lhr-solar/BPS-VoltTemp/hardware/VoltTemp/VoltTempBOM.xlsx

Reference | Value | P/N | Footprint | Qty | DNP
D15 | BQ_HB | XL-1608UBC-06A | LED_SMD:LED_0603_1608Metric_Pad1.05x0.95mm_HandSolder | 1
D10 | 3v3 | XL-1608UBC-06A | LED_SMD:LED_0603_1608Metric_Pad1.05x0.95mm_HandSolder | 1
R34,R38,R43,R44,R50 | 27k | TNPU060327K0AYEN00 | Resistor_SMD:R_0603_1608Metric_Pad0.98x0.95mm_HandSolder | 5
U4,U6,U12,U13,U14 | TLV9062xD | TLV9062QDGKRQ1 | Package_SO:SOIC-8_3.9x4.9mm_P1.27mm | 5
SW1 | BOOT | TL3365AF180QG | VoltTemp:SW_TL3365AF180QG | 1
R25,R26,R28,R30 | 0 | SFR03EZPJ000 | Resistor_SMD:R_0603_1608Metric_Pad0.98x0.95mm_HandSolder | 4
R23,R24,R27 | 0 | SFR03EZPJ000 | Resistor_SMD:R_0603_1608Metric_Pad0.98x0.95mm_HandSolder | 3
R35,R36,R39,R40,R45,R46,R47,R48,R51,R52 | 2.7k | SFR03EZPF2701 | Resistor_SMD:R_0603_1608Metric_Pad0.98x0.95mm_HandSolder | 10
J5 | Logic_Analyzer | SFH11-PBPC-D05-ST-BK | UTSVT_Connectors:CONN_SFH11-xxxC-D05-ST-XX_SUL | 1
F7,F8,F9,F10,F11 | 10mA | PTSLR06038V075 | VoltTemp:ptc_fuse_FUSC1607X75N | 5
D14 | BQ-Fault | NCD0603R1 | LED_SMD:LED_0603_1608Metric_Pad1.05x0.95mm_HandSolder | 1
C3,C26,C28,C29,C32,C34,C35,C36,C37,C38,C39,C40,C41 | 1uF | MLASU168SB5105KTNA01 | Capacitor_SMD:C_0603_1608Metric_Pad1.08x0.95mm_HandSolder,Capacitor_SMD:C_0805_2012Metric_Pad1.18x1.45mm_HandSolder | 13
C10,C11,C12,C13,C14,C15,C16,C17 | 100nF | MLASH168SB7104KTNA01 | Capacitor_SMD:C_0603_1608Metric_Pad1.08x0.95mm_HandSolder | 8
C5,C6,C7,C8,C9,C24,C42 | 0.1uF | MLASH168SB7104KTNA01 | Capacitor_SMD:C_0603_1608Metric_Pad1.08x0.95mm_HandSolder | 7
IC1 | ISO1641BDR | ISO1641BDR | VoltTemp:ISO1641BDR | 1
C2 | 10uF | GRM21BR61H106KE43K | Capacitor_SMD:C_0805_2012Metric | 1
F12 | 40mA | FUSC1607X75N | VoltTemp:ptc_fuse_FUSC1607X75N | 1
R53,R54,R55,R56,R57,R58,R59,R60 | 100Œ© | ESR03EZPF1000 | Resistor_SMD:R_0603_1608Metric_Pad0.98x0.95mm_HandSolder | 8
R1,R37,R41,R42,R49 | 8.2kŒ© | ERA-3AED822V | Resistor_SMD:R_0603_1608Metric_Pad0.98x0.95mm_HandSolder | 5
U1,U3 | EL3H7 | EL3H7(D)(TA)-VG | UTSVT_ICs:EL3H7 | 2
R31 | 4.3k | CRCW06034K30FKTA | Resistor_SMD:R_0603_1608Metric_Pad0.98x0.95mm_HandSolder | 1
R5 | 2k | CRCW06032K10FKEA | Resistor_SMD:R_0805_2012Metric | 1
R8,R12 | 1k | CRCW06031K00FKEI | Resistor_SMD:R_0603_1608Metric_Pad0.98x0.95mm_HandSolder | 2
R9,R10,R11,R13,R14,R15 | 10k | CRCW060310K0FKEI | Resistor_SMD:R_0603_1608Metric_Pad0.98x0.95mm_HandSolder | 6
R18,R19 | 120 | CRCW0603120RFKEC | Resistor_SMD:R_0603_1608Metric_Pad0.98x0.95mm_HandSolder | 2
R2 | 510k | CPF0603B510KE1 | Resistor_SMD:R_0603_1608Metric_Pad0.98x0.95mm_HandSolder | 1
C25,C27,C30,C31,C33 | 1.2uF | C0805C125K4RACTU | Capacitor_SMD:C_0805_2012Metric_Pad1.18x1.45mm_HandSolder | 5
U2 | BQ7692003PW | BQ7692003PW | VoltTemp:BQ7692003PW | 1
J10 | 53307-2471 | 53307-2471 | UTSVT_Connectors:PeripheralSOM | 1
D1 | D_Zener_Small | 1N448W | Diode_SMD:D_0805_2012Metric | 1
C18 | 4.7uF | 08055D475KAT4A | Capacitor_SMD:C_0805_2012Metric_Pad1.18x1.45mm_HandSolder | 1
C4 | 470pF | 06035C471J4Z2A | Capacitor_SMD:C_0603_1608Metric_Pad1.08x0.95mm_HandSolder | 1
J6,J7,J12,J13 | Conn_01x04 | 1053132104 | VoltTemp:1053132104 | 4
J11 | Conn_01x07 | 1053131107 | VoltTemp:1053131107 | 1
J8 | Conn_01x06 | 1053131106 | VoltTemp:1053131106 | 1
J9 | Conn_01x03 | 1053131103 | VoltTemp:1053131103 | 1
D2,D3,D4,D5,D6,D7,D8,D9 | WS2812B-2020 |  | LED_SMD:LED_WS2812B-2020_PLCC4_2.0x2.0mm | 8
