lhr-solar/BPS-VoltTemp/hardware/Scrutineering/BOM/Scrutineering.xlsx

Reference | Value | P/N | Footprint | Qty
J5,J6,J7,J8,J9,J10 | Conn_01x01 | 105-2210-201 | UTSVT_Connectors:Banana_Jack_1_Pin_4mm | 6
J11,J11 | Conn_01x02 | 1053132102 | UTSVT_Connectors:105313-2102 | 2
J3,J4 | Conn_01x03 | 1053131103 | VoltTemp:1053131103 | 2
J1,J2 | Conn_02x04 | 1053141108 | Scrutineering:nanofit_02x04 | 2
SW1,SW2,SW3,SW4 | SW_SPDT | OS102011MS2Q | Button_Switch_THT:SW_Slide_SPDT_Straight_CK_OS102011MS2Q | 4
