lhr-solar/BPS-VoltTemp/hardware/TestBoard_CellSimulator/BOM/CellSimulatorPCB_BOM.xlsx

Reference | Qty | Value | Footprint | Datasheet | P/N
J1,J2 | 2 | 575-4 | VoltTemp:5754 | https://www.digikey.com/en/products/detail/keystone-electronics/575-4/318493 | 575-4
J11 | 1 | Conn_01x07 | VoltTemp:1053131107 | ~ | 1053131107
R1,R2,R3,R4,R5 | 5 | 7.23 kŒ© | Resistor_SMD:R_0603_1608Metric_Pad0.98x0.95mm_HandSolder | https://www.mouser.com/ProductDetail/Vishay/TNPW06037K23BEEN?qs=m2vMjz15CltNt%2FYw8X6%252BTg%3D%3D | TNPW06037K23BEEN
TP9,TP10,TP11,TP12,TP13,TP14 | 6 | TestPoint | TestPoint:TestPoint_Keystone_5005-5009_Compact | ~ | 5005
