lhr-solar/BPS-VoltTemp/hardware/TestBoard_ThermistorBreakout/BOM/ThermistorBreakoutPCB_BOM.xlsx

Reference | Qty | Value | Footprint | Datasheet | P/N
J8 | 1 | Conn_01x06 | VoltTemp:1053131106 | ~ | 1053131106
R5,R6,R7,R8,R9,R10,R11,R12 | 8 | 6.49k | Resistor_SMD:R_0603_1608Metric_Pad0.98x0.95mm_HandSolder | https://www.mouser.com/ProductDetail/YAGEO/RT0603DRE076K49L?qs=4CyHz7GXqSi0aK3%2FrppBIQ%3D%3D | RT0603DRE076K49L
TH5,TH6,TH7,TH8 | 4 | Thermistor_NTC | UTSVT_Special:THERM_ERT-J1VR104FM | https://industrial.panasonic.com/cdbs/www-data/pdf/AUA0000/AUA0000C11.pdf | ERTJ1VR104FM
