lhr-solar/BPS-VoltTemp/hardware/spice/TemperatureFilter.asc

C1: cap; 1µ
C2: cap; 1.2µ
R1: res; 226.2k
R2: res; 6.49k
R3: res; 8.2k
R4: res; 27k
R5: res; 2.7k
R6: res; 2.7k
U1: opamp
U2: opamp
V1: voltage; 3.3
V2: voltage; 1; AC 1 1
Named nets: 3.3V-AC, 0, Vout, 3.3V, Buf, Filter
226.2k Ohm at 10C
6,834 Ohm at 85C
.op
.lib opamp.sub
