lhr-solar/BPS-VoltTemp/hardware/Scrutineering/Scrutineering.kicad_pcb

## KiCad design hardware/Scrutineering/Scrutineering.kicad_pcb (2025-09-22)

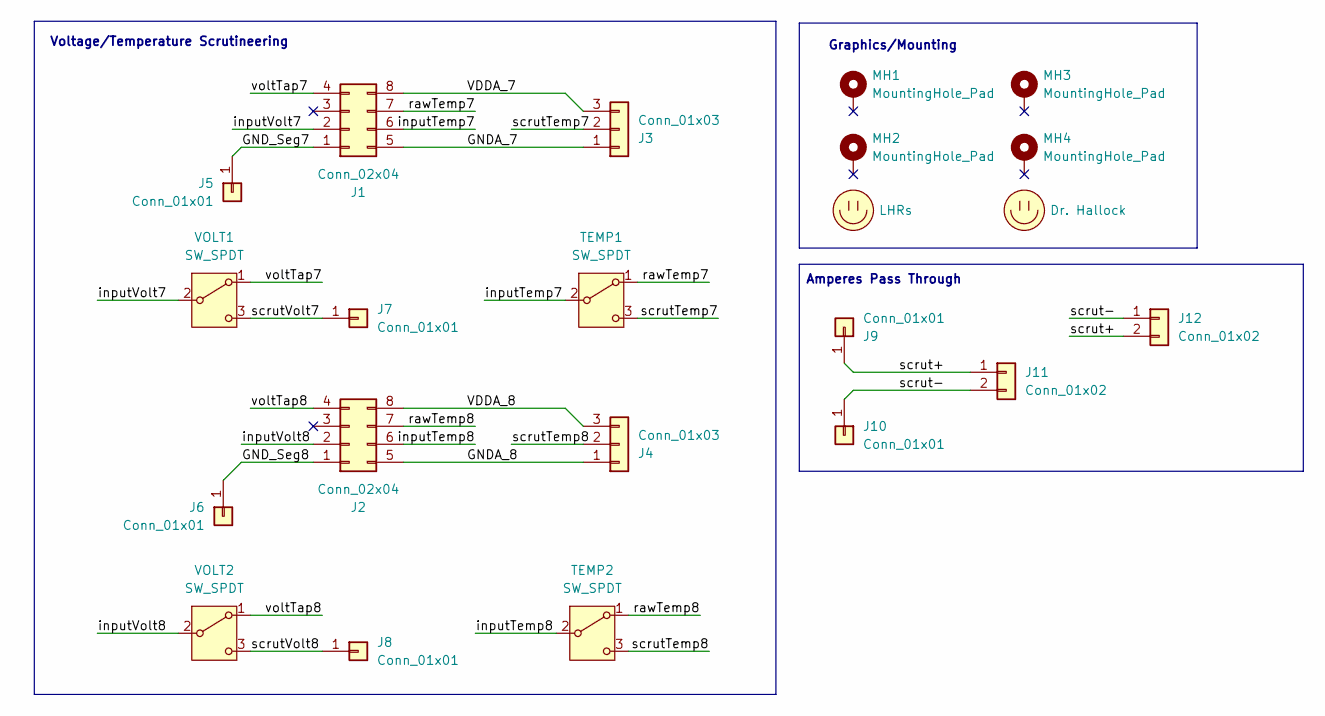
[picture p1: schematic Scrutineering.kicad_sch]

Parts:
J1, J2: Conn_02x04; nanofit_02x04
J3, J4: Conn_01x03; 1053131103
J5, J6, J7, J8, J9, J10: Conn_01x01; Banana_Jack_1_Pin_4mm
J11, J12: Conn_01x02; 105313-2102
LOGO1: Dr. Hallock; Hallock_Image_Small
LOGO2: LHRs; LHRs_LOGO
MH1, MH2, MH3, MH4: MountingHole_Pad; MountingHole_3.2mm_M3_Pad_TopBottom
TEMP1, TEMP2: SW_SPDT; SW_Slide_SPDT_Straight_CK_OS102011MS2Q
VOLT1, VOLT2: SW_SPDT; SW_Slide_SPDT_Straight_CK_OS102011MS2Q

Connections:
/GNDA_7: J1.5, J3.1
/GNDA_8: J2.5, J4.1
/GND_Seg7: J1.1, J5.1
/GND_Seg8: J2.1, J6.1
/VDDA_7: J1.8, J3.3
/VDDA_8: J2.8, J4.3
/inputTemp7: J1.6, TEMP1.2 (B)
/inputTemp8: J2.6, TEMP2.2 (B)
/inputVolt7: J1.2, VOLT1.2 (B)
/inputVolt8: J2.2, VOLT2.2 (B)
/rawTemp7: J1.7, TEMP1.1 (A)
/rawTemp8: J2.7, TEMP2.1 (A)
/scrut+: J9.1, J11.1, J12.2
/scrut-: J10.1, J11.2, J12.1
/scrutTemp7: J3.2, TEMP1.3 (C)
/scrutTemp8: J4.2, TEMP2.3 (C)
/scrutVolt7: J7.1, VOLT1.3 (C)
/scrutVolt8: J8.1, VOLT2.3 (C)
/voltTap7: J1.4, VOLT1.1 (A)
/voltTap8: J2.4, VOLT2.1 (A)

Notes on the sheet:
Amperes Pass Through
Voltage/Temperature Scrutineering
Graphics/Mounting

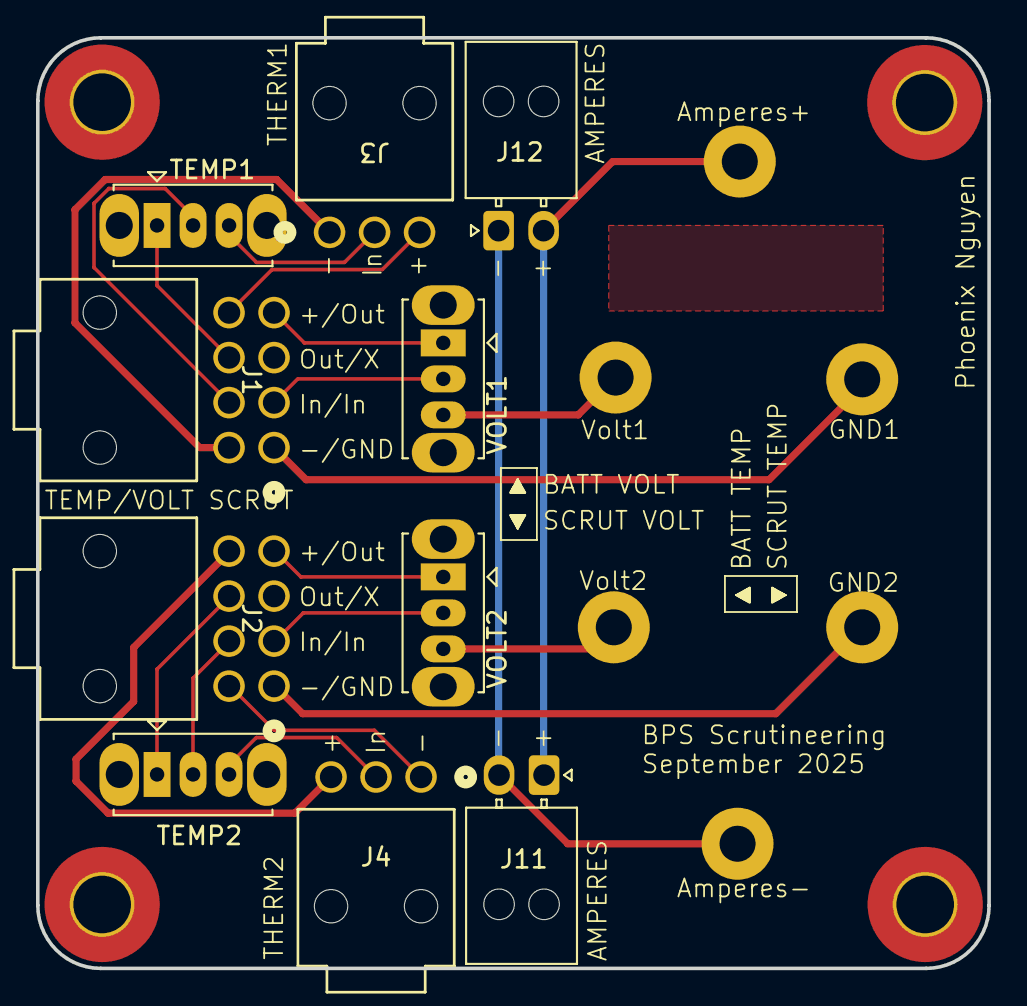
[picture p2: board Scrutineering.kicad_pcb from above]

Board: 2 copper layers, 52.8 x 51.7 mm, 22 parts (1 on the bottom side), 20 nets.
