lhr-solar/BPS-VoltTemp/hardware/TestBoard_CellSimulator/CellSimulatorPCB.kicad_pcb

## KiCad design hardware/TestBoard_CellSimulator/CellSimulatorPCB.kicad_pcb (2025-08-24)

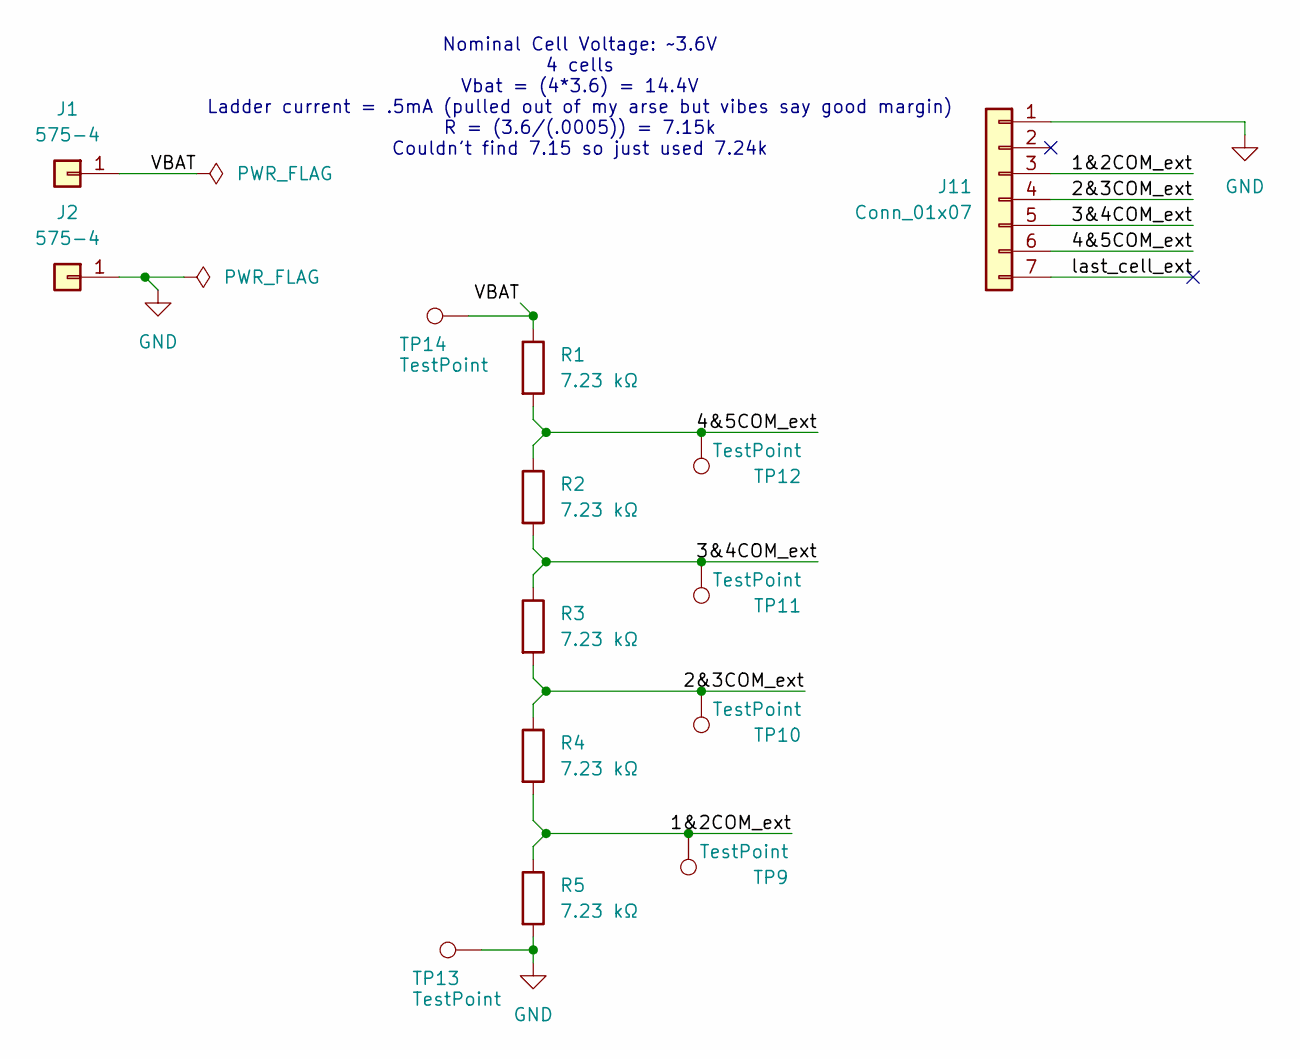
[picture p3: schematic CellSimulatorPCB.kicad_sch]

Parts:
J1, J2: 575-4; 5754
J11: Conn_01x07; 1053131107
R1, R2, R3, R4, R5: 7.23 kΩ; R_0603_1608Metric_Pad0.98x0.95mm_HandSolder
TP9, TP10, TP11, TP12, TP13, TP14: TestPoint; TestPoint_Keystone_5005-5009_Compact

Connections:
/1&2COM_ext: J11.3, R4.2, R5.1, TP9.1
/2&3COM_ext: J11.4, R3.2, R4.1, TP10.1
/3&4COM_ext: J11.5, R2.2, R3.1, TP11.1
/4&5COM_ext: J11.6, R1.2, R2.1, TP12.1
/VBAT: J1.1, R1.1, TP14.1
/last_cell_ext: J11.7
GND: J2.1, J11.1, R5.2, TP13.1

Notes on the sheet:
Nominal Cell Voltage: ~3.6V 4 cells Vbat = (4*3.6) = 14.4V Ladder current = .5mA (pulled out of my arse but vibes say good margin) R = (3.6/(.0005)) = 7.15k Couldn't find 7.15 so just used 7.24k

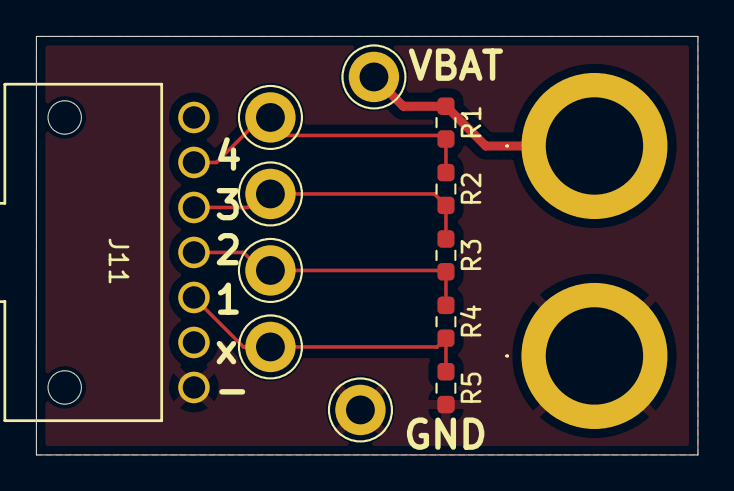
[picture p4: board CellSimulatorPCB.kicad_pcb from above]

Board: 2 copper layers, 36.8 x 23.2 mm, 14 parts (0 on the bottom side), 6 nets.
