lhr-solar/BPS-VoltTemp/hardware/TestBoard_ThermistorBreakout/ThermistorBreakoutPCB.kicad_pcb

## KiCad design hardware/TestBoard_ThermistorBreakout/ThermistorBreakoutPCB.kicad_pcb (2025-08-22)

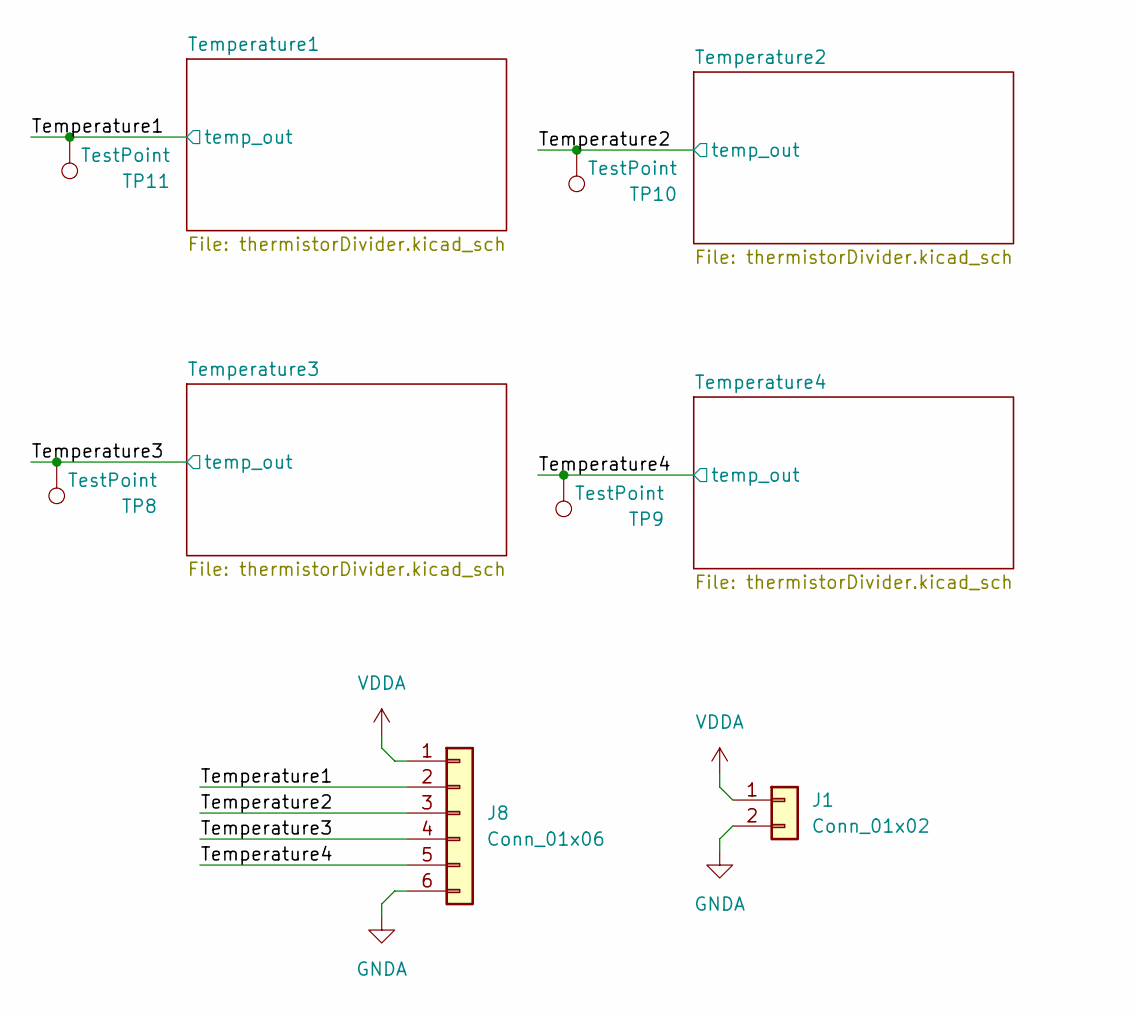
[picture p5: schematic ThermistorBreakoutPCB.kicad_sch]

Parts:
J1: Conn_01x02; PinHeader_1x02_P2.54mm_Vertical
J8: Conn_01x06; 1053131106
TP8, TP9, TP10, TP11: TestPoint; TestPoint_Keystone_5005-5009_Compact

Connections:
/Temperature1: J8.2, TP11.1; also elsewhere on the board
/Temperature2: J8.3, TP10.1; also elsewhere on the board
/Temperature3: J8.4, TP8.1; also elsewhere on the board
/Temperature4: J8.5, TP9.1; also elsewhere on the board
GNDA: J1.2, J8.6; also elsewhere on the board
VDDA: J1.1, J8.1; also elsewhere on the board

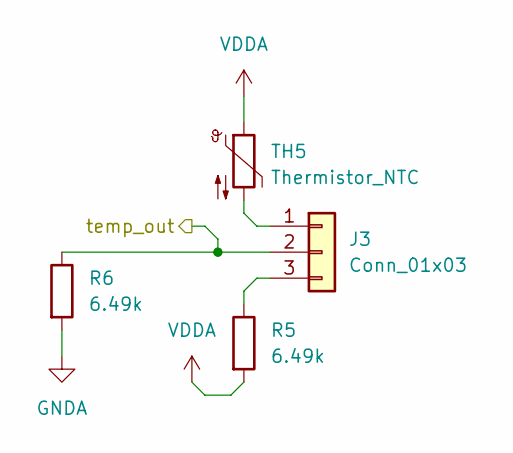
[picture p6: schematic thermistorDivider.kicad_sch]

Parts:
J3: Conn_01x03; PinHeader_1x03_P2.54mm_Vertical
R5, R6: 6.49k; R_0603_1608Metric_Pad0.98x0.95mm_HandSolder
TH5: Thermistor_NTC; THERM_ERT-J1VR104FM

Connections:
/Temperature1: J3.2, R6.1; also elsewhere on the board
GNDA: R6.2; also elsewhere on the board
unnamed: J3.1, TH5.2
unnamed: J3.3, R5.1
VDDA: R5.2, TH5.1; also elsewhere on the board

Parts of its further copies:
J4, J5, J6: Conn_01x03; PinHeader_1x03_P2.54mm_Vertical
R7, R8, R9, R10, R11, R12: 6.49k; R_0603_1608Metric_Pad0.98x0.95mm_HandSolder
TH6, TH7, TH8: Thermistor_NTC; THERM_ERT-J1VR104FM

Connections of its further copies:
/Temperature2: J4.2, R7.1; also elsewhere on the board
/Temperature3: J5.2, R9.1; also elsewhere on the board
/Temperature4: J6.2, R10.1; also elsewhere on the board
GNDA: R7.2, R9.2, R10.2; also elsewhere on the board
unnamed: J4.1, TH6.2
unnamed: J4.3, R8.1
unnamed: J5.1, TH7.2
unnamed: J5.3, R11.1
unnamed: J6.1, TH8.2
unnamed: J6.3, R12.1
VDDA: R8.2, R11.2, R12.2, TH6.1, TH7.1, TH8.1; also elsewhere on the board

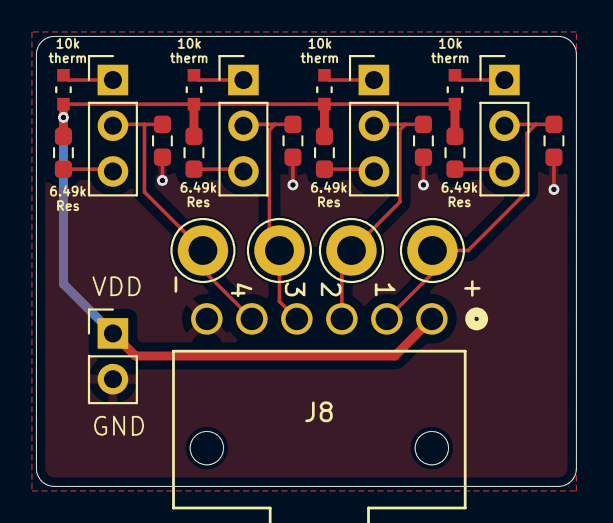
[picture p7: board ThermistorBreakoutPCB.kicad_pcb from above]

Board: 2 copper layers, 30.0 x 25.0 mm, 22 parts (0 on the bottom side), 14 nets.
