lhr-solar/BPS-VoltTemp/hardware/VoltTemp/BPS-Voltage_Temp_Board.kicad_pcb

## KiCad design hardware/VoltTemp/BPS-Voltage_Temp_Board.kicad_pcb (2025-08-26)

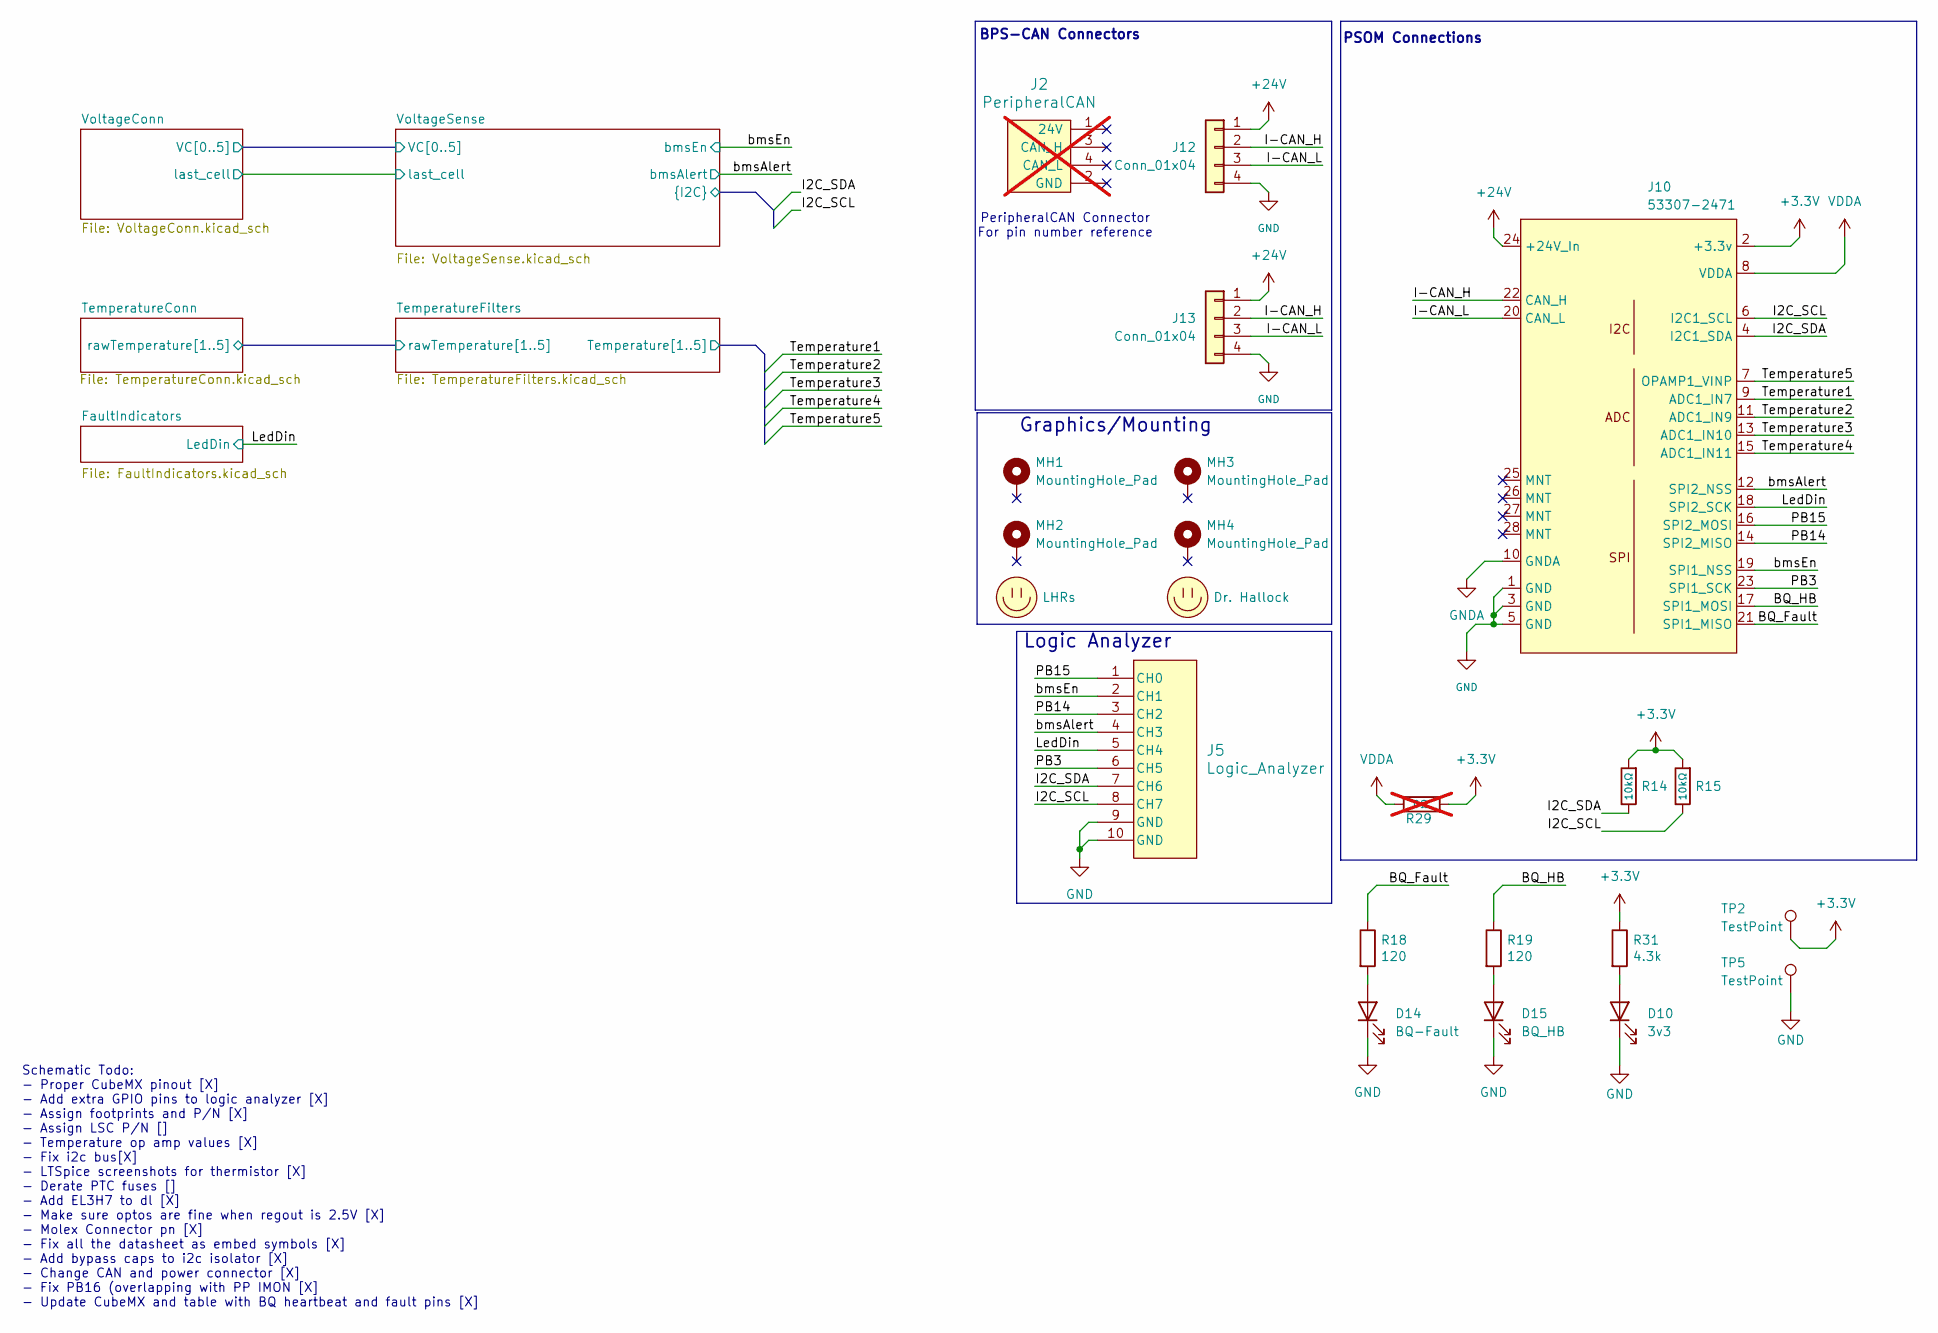
[picture p8: schematic BPS-Voltage_Temp_Board.kicad_sch, BPS Voltage&Temperature board]

Parts:
D10: 3v3; LED_0603_1608Metric_Pad1.05x0.95mm_HandSolder
D14: BQ-Fault; LED_0603_1608Metric_Pad1.05x0.95mm_HandSolder
D15: BQ_HB; LED_0603_1608Metric_Pad1.05x0.95mm_HandSolder
J2: PeripheralCAN; Molex_Nano-Fit_105309-xx04_1x04_P2.50mm_Vertical; not fitted
J5: Logic_Analyzer; CONN_SFH11-xxxC-D05-ST-XX_SUL
J10: 53307-2471; PeripheralSOM
J12, J13: Conn_01x04; 1053132104
LOGO1: Dr. Hallock; Hallock_Image_Small
LOGO2: LHRs; LHRs_LOGO
MH1, MH2, MH3, MH4: MountingHole_Pad; MountingHole_3.2mm_M3_Pad_TopBottom
R14, R15: 10kΩ; R_0603_1608Metric_Pad0.98x0.95mm_HandSolder
R18, R19: 120; R_0603_1608Metric_Pad0.98x0.95mm_HandSolder
R29: 0Ω; R_0603_1608Metric_Pad0.98x0.95mm_HandSolder; not fitted
R31: 4.3k; R_0603_1608Metric_Pad0.98x0.95mm_HandSolder
TP2, TP5: TestPoint; TestPoint_Pad_1.0x1.0mm

Connections:
+3.3V: J10.2 (+3.3v), R14.2, R15.2, R29.2, R31.1, TP2.1; also elsewhere on the board
+24V: J10.24 (+24V_In), J12.1, J13.1
/BQ_Fault: J10.21 (SPI1_MISO), R18.1
/BQ_HB: J10.17 (SPI1_MOSI), R19.1
/I-CAN_H: J10.22 (CAN_H), J12.2, J13.2
/I-CAN_L: J10.20 (CAN_L), J12.3, J13.3
/LedDin: J5.5 (CH4), J10.18 (SPI2_SCK); also elsewhere on the board
/PB3: J5.6 (CH5), J10.23 (SPI1_SCK)
/PB14: J5.3 (CH2), J10.14 (SPI2_MISO)
/PB15: J5.1 (CH0), J10.16 (SPI2_MOSI)
/TemperatureFilters/Temperature1: J10.9 (ADC1_IN7); also elsewhere on the board
/TemperatureFilters/Temperature2: J10.11 (ADC1_IN9); also elsewhere on the board
/TemperatureFilters/Temperature3: J10.13 (ADC1_IN10); also elsewhere on the board
/TemperatureFilters/Temperature4: J10.15 (ADC1_IN11); also elsewhere on the board
/TemperatureFilters/Temperature5: J10.7 (OPAMP1_VINP); also elsewhere on the board
/VoltageSense/I2C_SCL: J5.8 (CH7), J10.6 (I2C1_SCL), R15.1; also elsewhere on the board
/VoltageSense/I2C_SDA: J5.7 (CH6), J10.4 (I2C1_SDA), R14.1; also elsewhere on the board
/bmsAlert: J5.4 (CH3), J10.12 (SPI2_NSS); also elsewhere on the board
/bmsEn: J5.2 (CH1), J10.19 (SPI1_NSS); also elsewhere on the board
GND: D10.1 (K), D14.1 (K), D15.1 (K), J5.9 (GND), J5.10 (GND), J10.1 (GND), J10.3 (GND), J10.5 (GND), J12.4, J13.4, TP5.1; also elsewhere on the board
GNDA: J10.10 (GNDA); also elsewhere on the board
unnamed: D10.2 (A), R31.2
unnamed: D14.2 (A), R18.2
unnamed: D15.2 (A), R19.2
VDDA: J10.8 (VDDA), R29.1; also elsewhere on the board

Notes on the sheet:
BPS-CAN Connectors
Logic Analyzer
Schematic Todo: - Proper CubeMX pinout [X] - Add extra GPIO pins to logic analyzer [X] - Assign footprints and P/N [X] - Assign LSC P/N [] - Temperature op amp values [X] - Fix i2c bus[X] - LTSpice screenshots for thermistor [X] - Derate PTC fuses [] - Add EL3H7 to dl [X] - Make sure optos are fine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
PSOM Connections
PeripheralCAN Connector For pin number reference
Graphics/Mounting

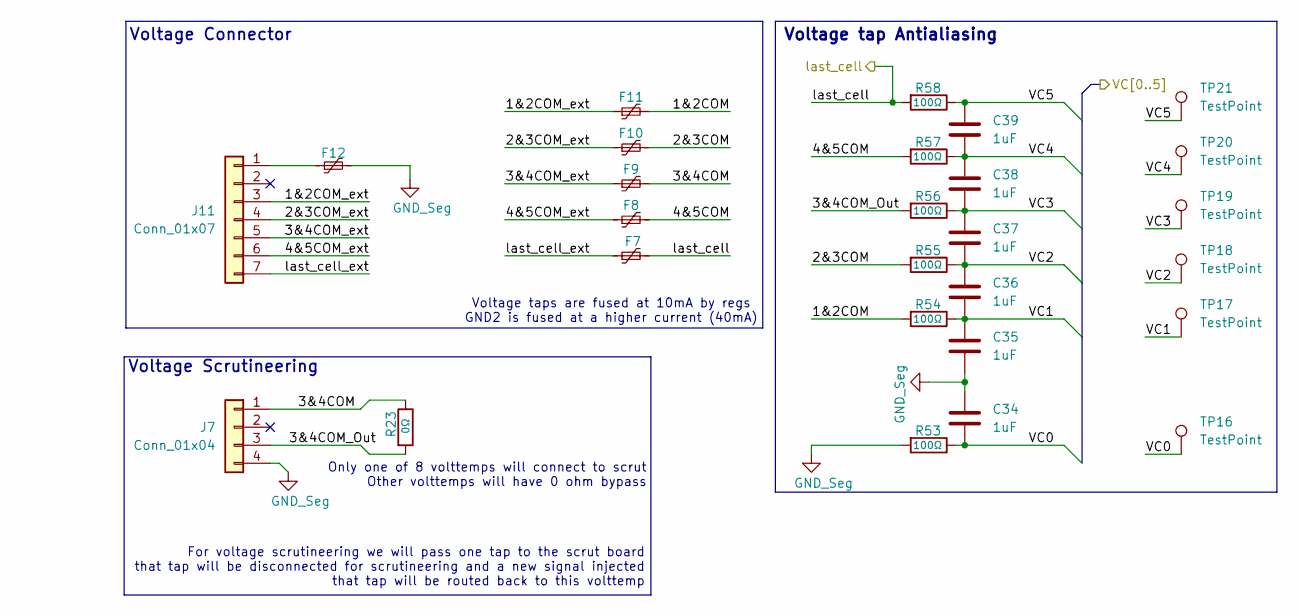
[picture p9: schematic VoltageConn.kicad_sch]

Parts:
C34, C35, C36, C37, C38, C39: 1uF; C_0603_1608Metric_Pad1.08x0.95mm_HandSolder
F7, F8, F9, F10, F11: 10mA; ptc_fuse_FUSC1607X75N
F12: 40mA; ptc_fuse_FUSC1607X75N
J7: Conn_01x04; 1053132104
J11: Conn_01x07; 1053131107
R23: 0Ω; R_0603_1608Metric_Pad0.98x0.95mm_HandSolder
R53, R54, R55, R56, R57, R58: 100Ω; R_0603_1608Metric_Pad0.98x0.95mm_HandSolder
TP16, TP17, TP18, TP19, TP20, TP21: TestPoint; TestPoint_Pad_1.5x1.5mm

Connections:
/VoltageConn/1&2COM: F11.2, R54.2
/VoltageConn/1&2COM_ext: F11.1, J11.3
/VoltageConn/2&3COM: F10.2, R55.2
/VoltageConn/2&3COM_ext: F10.1, J11.4
/VoltageConn/3&4COM: F9.2, J7.1, R23.1
/VoltageConn/3&4COM_Out: J7.3, R23.2, R56.2
/VoltageConn/3&4COM_ext: F9.1, J11.5
/VoltageConn/4&5COM: F8.2, R57.2
/VoltageConn/4&5COM_ext: F8.1, J11.6
/VoltageConn/VC0: C34.2, R53.1, TP16.1; also elsewhere on the board
/VoltageConn/VC1: C35.1, C36.2, R54.1, TP17.1; also elsewhere on the board
/VoltageConn/VC2: C36.1, C37.2, R55.1, TP18.1; also elsewhere on the board
/VoltageConn/VC3: C37.1, C38.2, R56.1, TP19.1; also elsewhere on the board
/VoltageConn/VC4: C38.1, C39.2, R57.1, TP20.1; also elsewhere on the board
/VoltageConn/VC5: C39.1, R58.1, TP21.1; also elsewhere on the board
/VoltageConn/last_cell: F7.2, R58.2; also elsewhere on the board
/VoltageConn/last_cell_ext: F7.1, J11.7
GND_Seg: C34.1, C35.2, F12.2, J7.4, R53.2; also elsewhere on the board
unnamed: F12.1, J11.1

Notes on the sheet:
Voltage Connector
Voltage tap Antialiasing
For voltage scrutineering we will pass one tap to the scrut board that tap will be disconnected for scrutineering and a new signal injected that tap will be routed back to this volttemp
Voltage taps are fused at 10mA by regs GND2 is fused at a higher current (40mA)
Voltage Scrutineering
Only one of 8 volttemps will connect to scrut Other volttemps will have 0 ohm bypass

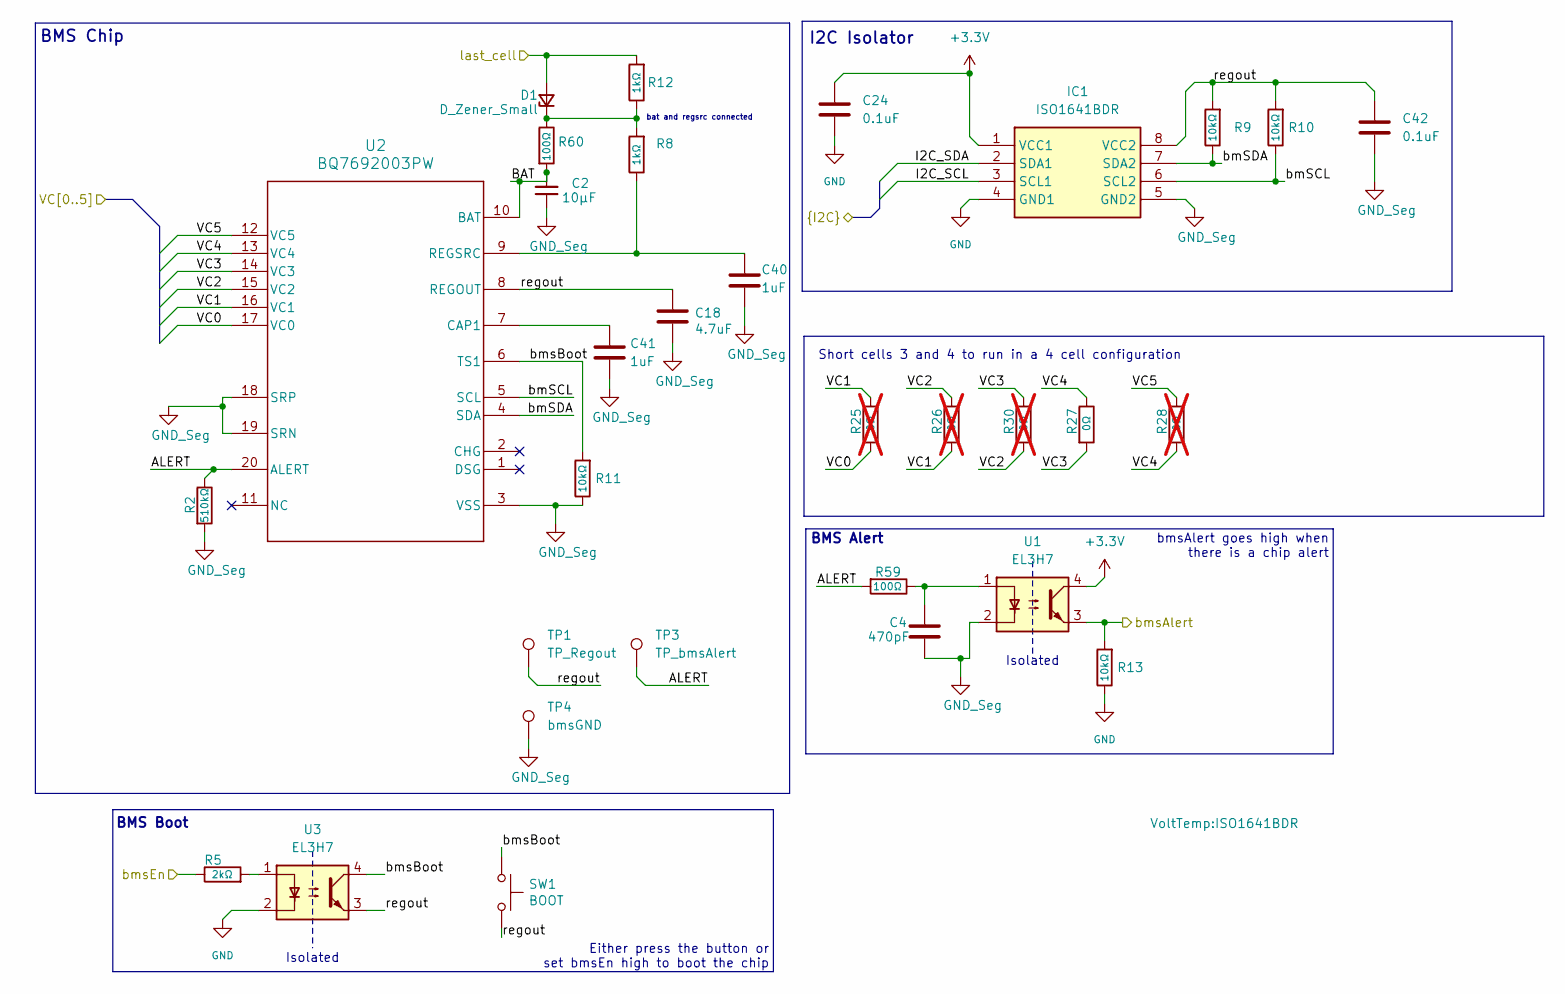
[picture p10: schematic VoltageSense.kicad_sch]

Parts:
C2: 10μF; C_0805_2012Metric
C4: 470pF; C_0603_1608Metric_Pad1.08x0.95mm_HandSolder
C18: 4.7uF; C_0805_2012Metric_Pad1.18x1.45mm_HandSolder
C24, C42: 0.1uF; C_0603_1608Metric_Pad1.08x0.95mm_HandSolder
C40, C41: 1uF; C_0603_1608Metric_Pad1.08x0.95mm_HandSolder
D1: D_Zener_Small; D_0805_2012Metric
IC1: ISO1641BDR; Mouser Part Number 595-ISO1641BDR
R2: 510kΩ; R_0603_1608Metric_Pad0.98x0.95mm_HandSolder
R5: 2kΩ; R_0805_2012Metric
R8, R12: 1kΩ; R_0603_1608Metric_Pad0.98x0.95mm_HandSolder
R9, R10, R11, R13: 10kΩ; R_0603_1608Metric_Pad0.98x0.95mm_HandSolder
R25, R26, R28, R30: 0Ω; R_0603_1608Metric_Pad0.98x0.95mm_HandSolder; not fitted
R27: 0Ω; R_0603_1608Metric_Pad0.98x0.95mm_HandSolder
R59, R60: 100Ω; R_0603_1608Metric_Pad0.98x0.95mm_HandSolder
SW1: BOOT; SW_TL3365AF180QG
TP1: TP_Regout; TestPoint_Pad_1.0x1.0mm
TP3: TP_bmsAlert; TestPoint_Pad_1.0x1.0mm
TP4: bmsGND; TestPoint_Pad_1.0x1.0mm
U1, U3: EL3H7
U2: BQ7692003PW

Connections:
+3.3V: C24.1, IC1.1 (VCC1), U1.4; also elsewhere on the board
/VoltageConn/VC0: R25.2, U2.17 (VC0); also elsewhere on the board
/VoltageConn/VC1: R25.1, R26.2, U2.16 (VC1); also elsewhere on the board
/VoltageConn/VC2: R26.1, R30.2, U2.15 (VC2); also elsewhere on the board
/VoltageConn/VC3: R27.2, R30.1, U2.14 (VC3); also elsewhere on the board
/VoltageConn/VC4: R27.1, R28.2, U2.13 (VC4); also elsewhere on the board
/VoltageConn/VC5: R28.1, U2.12 (VC5); also elsewhere on the board
/VoltageConn/last_cell: D1.2 (A), R12.2; also elsewhere on the board
/VoltageSense/ALERT: R2.1, R59.2, TP3.1, U2.20 (ALERT)
/VoltageSense/BAT: C2.2, R60.2, U2.10 (BAT)
/VoltageSense/I2C_SCL: IC1.3 (SCL1); also elsewhere on the board
/VoltageSense/I2C_SDA: IC1.2 (SDA1); also elsewhere on the board
/VoltageSense/bmSCL: IC1.6 (SCL2), R10.1, U2.5 (SCL)
/VoltageSense/bmSDA: IC1.7 (SDA2), R9.1, U2.4 (SDA)
/VoltageSense/bmsBoot: R11.2, SW1.1, U2.6 (TS1), U3.4
/VoltageSense/regout: C18.1, C42.1, IC1.8 (VCC2), R9.2, R10.2, SW1.2, TP1.1, U2.8 (REGOUT), U3.3
/bmsAlert: R13.2, U1.3; also elsewhere on the board
/bmsEn: R5.1; also elsewhere on the board
GND: C24.2, IC1.4 (GND1), R13.1, U3.2; also elsewhere on the board
GND_Seg: C2.1, C4.2, C18.2, C40.2, C41.2, C42.2, IC1.5 (GND2), R2.2, R11.1, TP4.1, U1.2, U2.3 (VSS), U2.18 (SRP), U2.19 (SRN); also elsewhere on the board
unnamed: C4.1, R59.1, U1.1
unnamed: D1.1 (K), R8.2, R12.1, R60.1
unnamed: R5.2, U3.1
unnamed: C41.1, U2.7 (CAP1)
unnamed: C40.1, R8.1, U2.9 (REGSRC)

Notes on the sheet:
Isolated
BMS Chip
Short cells 3 and 4 to run in a 4 cell configuration
bat and regsrc connected
BMS Boot
BMS Alert
Either press the button or set bmsEn high to boot the chip
I2C Isolator
bmsAlert goes high when there is a chip alert

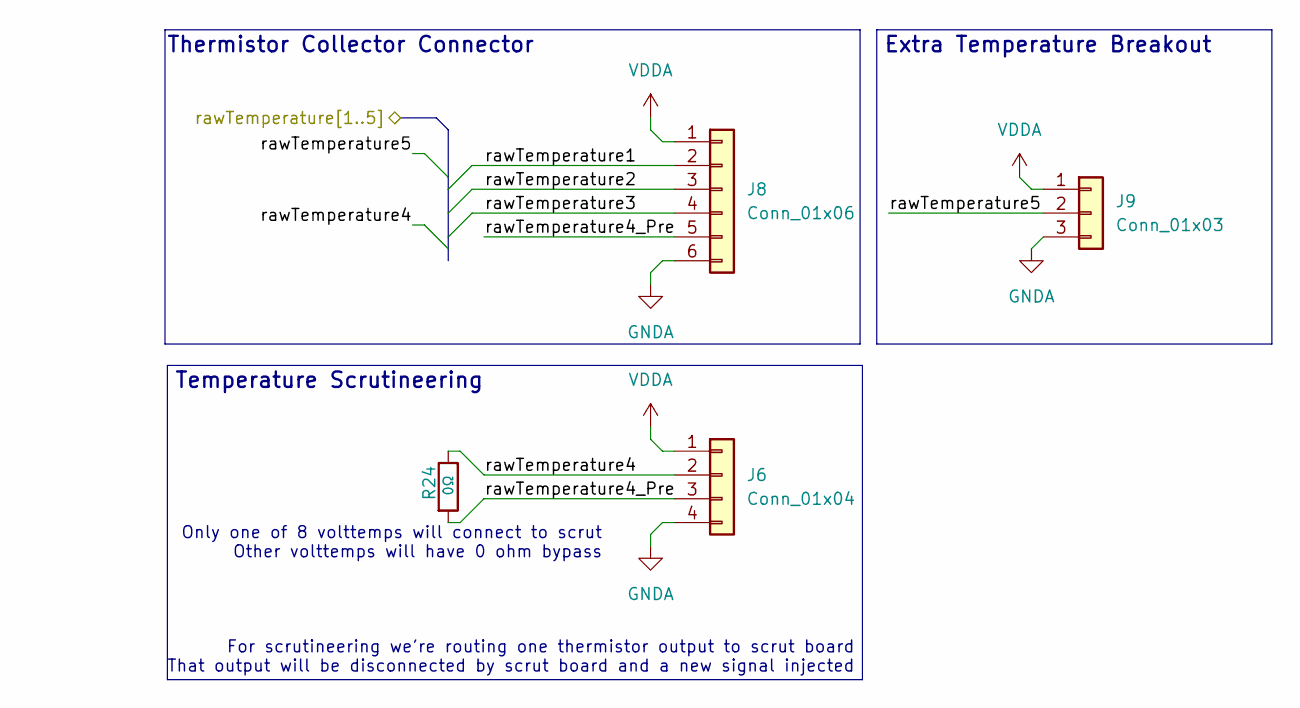
[picture p11: schematic TemperatureConn.kicad_sch]

Parts:
J6: Conn_01x04; 1053132104
J8: Conn_01x06; 1053131106
J9: Conn_01x03; 1053131103
R24: 0Ω; R_0603_1608Metric_Pad0.98x0.95mm_HandSolder

Connections:
/TemperatureConn/rawTemperature1: J8.2; also elsewhere on the board
/TemperatureConn/rawTemperature2: J8.3; also elsewhere on the board
/TemperatureConn/rawTemperature3: J8.4; also elsewhere on the board
/TemperatureConn/rawTemperature4: J6.2, R24.1; also elsewhere on the board
/TemperatureConn/rawTemperature4_Pre: J6.3, J8.5, R24.2
/TemperatureConn/rawTemperature5: J9.2; also elsewhere on the board
GNDA: J6.4, J8.6, J9.3; also elsewhere on the board
VDDA: J6.1, J8.1, J9.1; also elsewhere on the board

Notes on the sheet:
For scrutineering we're routing one thermistor output to scrut board That output will be disconnected by scrut board and a new signal injected
Only one of 8 volttemps will connect to scrut Other volttemps will have 0 ohm bypass
Temperature Scrutineering
Thermistor Collector Connector
Extra Temperature Breakout

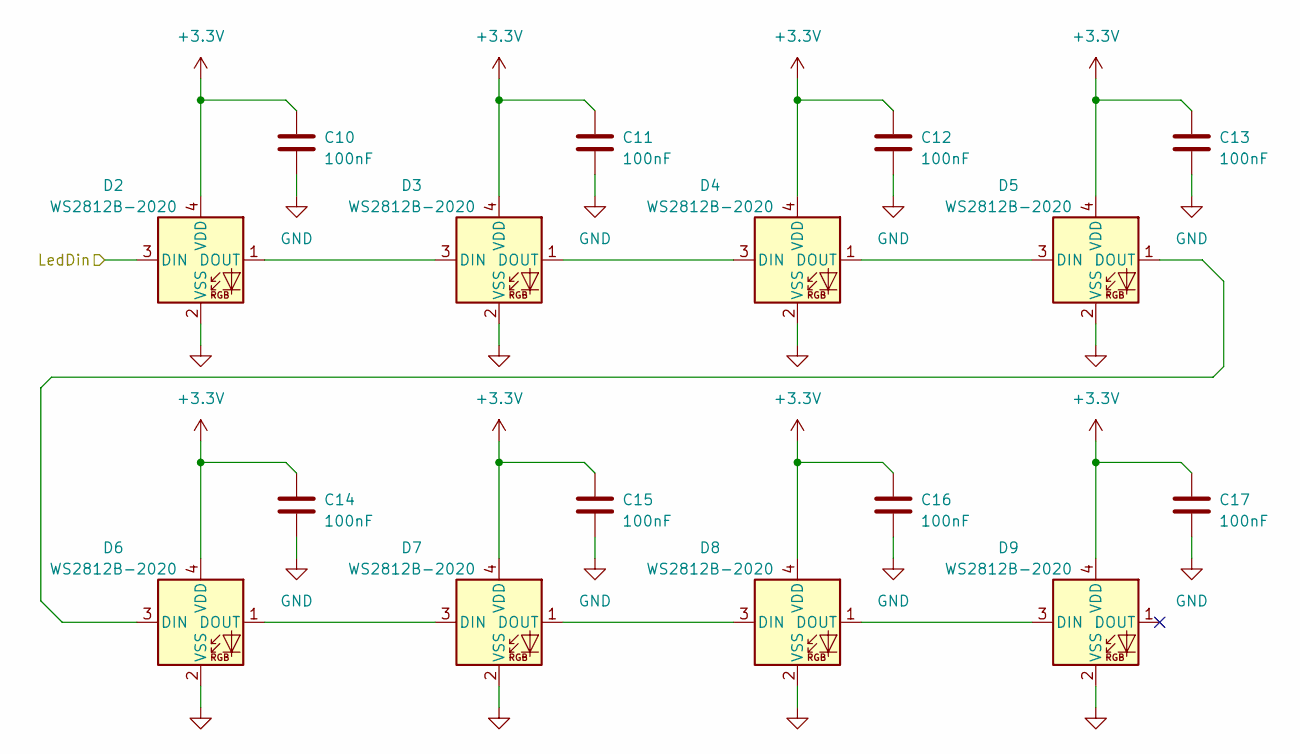
[picture p12: schematic FaultIndicators.kicad_sch]

Parts:
C10, C11, C12, C13, C14, C15, C16, C17: 100nF; C_0603_1608Metric_Pad1.08x0.95mm_HandSolder
D2, D3, D4, D5, D6, D7, D8, D9: WS2812B-2020; LED_WS2812B-2020_PLCC4_2.0x2.0mm

Connections:
+3.3V: C10.1, C11.1, C12.1, C13.1, C14.1, C15.1, C16.1, C17.1, D2.4 (VDD), D3.4 (VDD), D4.4 (VDD), D5.4 (VDD), D6.4 (VDD), D7.4 (VDD), D8.4 (VDD), D9.4 (VDD); also elsewhere on the board
/LedDin: D2.3 (DIN); also elsewhere on the board
GND: C10.2, C11.2, C12.2, C13.2, C14.2, C15.2, C16.2, C17.2, D2.2 (VSS), D3.2 (VSS), D4.2 (VSS), D5.2 (VSS), D6.2 (VSS), D7.2 (VSS), D8.2 (VSS), D9.2 (VSS); also elsewhere on the board
unnamed: D2.1 (DOUT), D3.3 (DIN)
unnamed: D3.1 (DOUT), D4.3 (DIN)
unnamed: D4.1 (DOUT), D5.3 (DIN)
unnamed: D5.1 (DOUT), D6.3 (DIN)
unnamed: D6.1 (DOUT), D7.3 (DIN)
unnamed: D7.1 (DOUT), D8.3 (DIN)
unnamed: D8.1 (DOUT), D9.3 (DIN)
