lhr-solar/BPS-VoltTemp/hardware/VoltTemp/BPS-Voltage_Temp_Board.kicad_pcb

## KiCad design hardware/VoltTemp/BPS-Voltage_Temp_Board.kicad_pcb (continued)

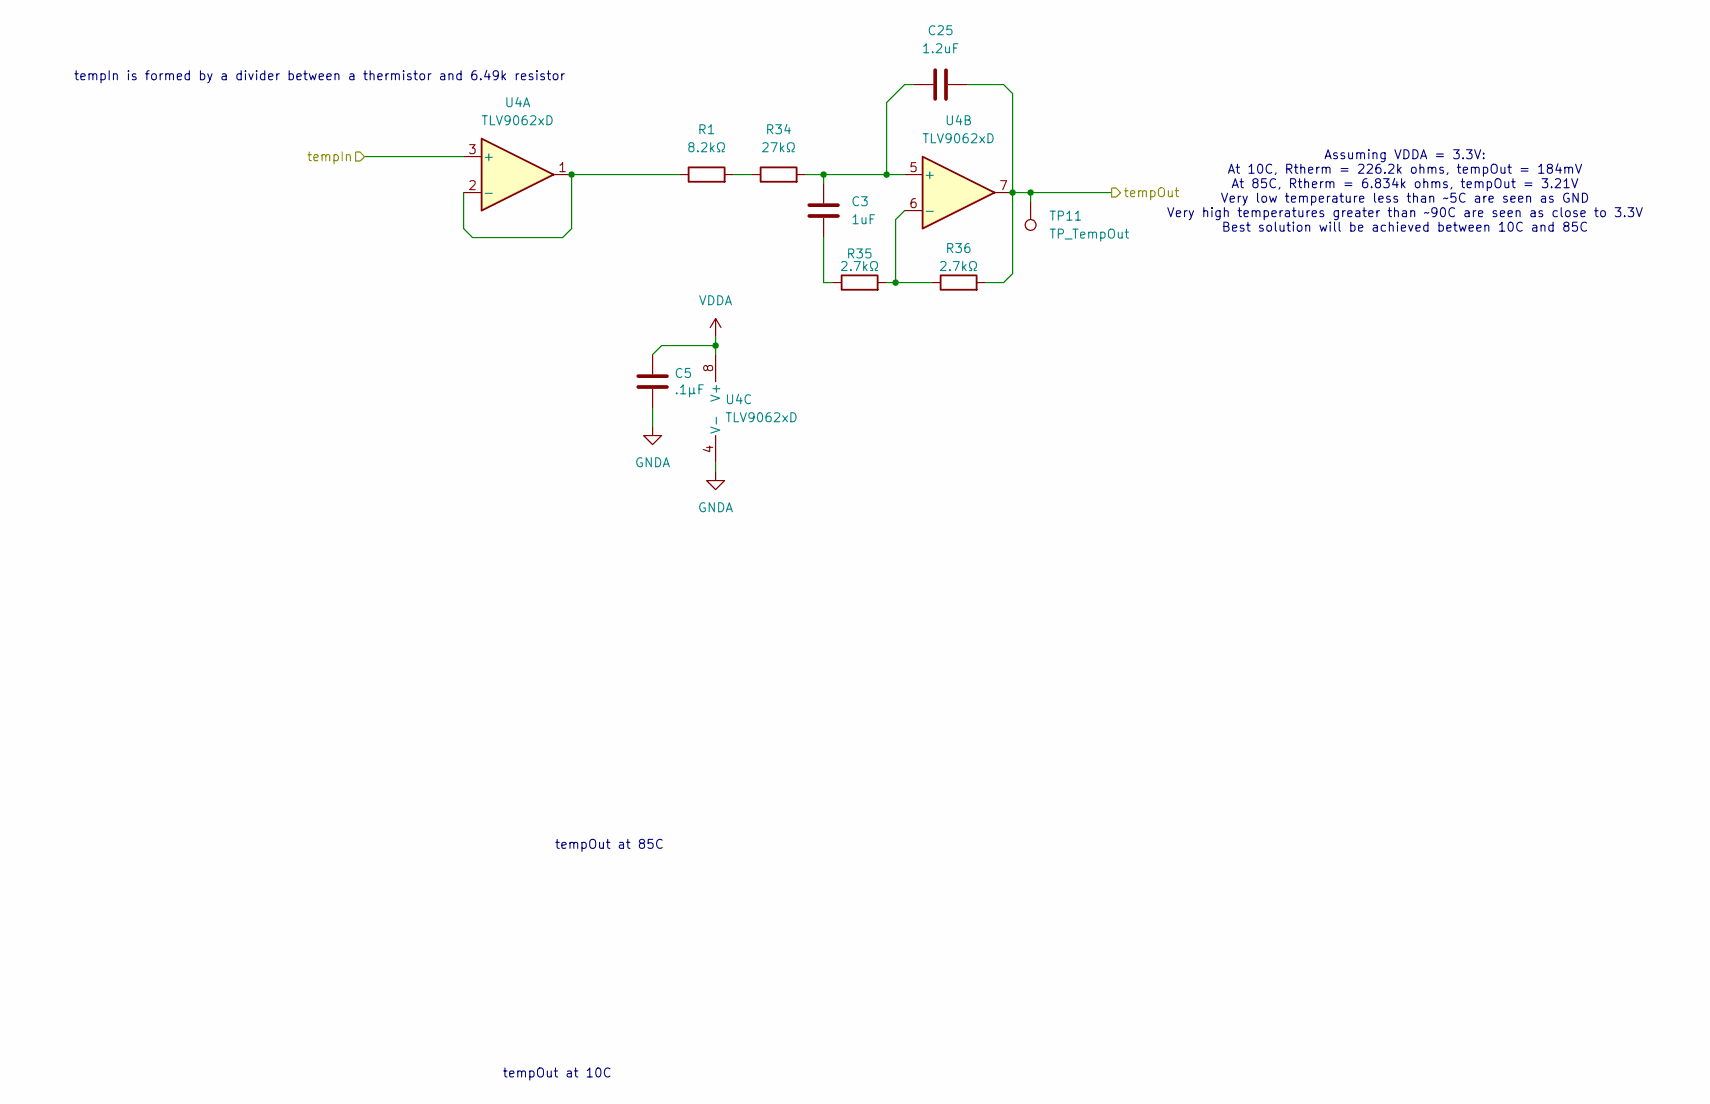
[picture p13: schematic TemperatureFilter.kicad_sch]

Parts:
C3: 1uF; C_0805_2012Metric_Pad1.18x1.45mm_HandSolder
C5: .1μF; C_0603_1608Metric_Pad1.08x0.95mm_HandSolder
C25: 1.2uF; C_0805_2012Metric_Pad1.18x1.45mm_HandSolder
R1: 8.2kΩ; R_0603_1608Metric_Pad0.98x0.95mm_HandSolder
R34: 27kΩ; R_0603_1608Metric_Pad0.98x0.95mm_HandSolder
R35, R36: 2.7kΩ; R_0603_1608Metric_Pad0.98x0.95mm_HandSolder
TP11: TP_TempOut; TestPoint_Pad_1.0x1.0mm
U4: TLV9062xD; SOIC-8_3.9x4.9mm_P1.27mm

Connections:
/TemperatureConn/rawTemperature4: U4.3 (+); also elsewhere on the board
/TemperatureFilters/Temperature4: C25.2, R36.2, TP11.1, U4.7; also elsewhere on the board
GNDA: C5.2, U4.4 (V-); also elsewhere on the board
unnamed: C3.2, R35.1
unnamed: R1.2, R34.1
unnamed: R1.1, U4.1, U4.2 (-)
unnamed: C3.1, C25.1, R34.2, U4.5 (+)
unnamed: R35.2, R36.1, U4.6 (-)
VDDA: C5.1, U4.8 (V+); also elsewhere on the board

Parts of its further copies:
C6, C7, C8, C9: .1μF; C_0603_1608Metric_Pad1.08x0.95mm_HandSolder
C26, C28, C29, C32: 1uF; C_0805_2012Metric_Pad1.18x1.45mm_HandSolder
C27, C30, C31, C33: 1.2uF; C_0805_2012Metric_Pad1.18x1.45mm_HandSolder
R37, R41, R42, R49: 8.2kΩ; R_0603_1608Metric_Pad0.98x0.95mm_HandSolder
R38, R43, R44, R50: 27kΩ; R_0603_1608Metric_Pad0.98x0.95mm_HandSolder
R39, R40, R45, R46, R47, R48, R51, R52: 2.7kΩ; R_0603_1608Metric_Pad0.98x0.95mm_HandSolder
TP12, TP13, TP14, TP15: TP_TempOut; TestPoint_Pad_1.0x1.0mm
U6, U12, U13, U14: TLV9062xD; SOIC-8_3.9x4.9mm_P1.27mm

Connections of its further copies:
/TemperatureConn/rawTemperature1: U13.3 (+); also elsewhere on the board
/TemperatureConn/rawTemperature2: U12.3 (+); also elsewhere on the board
/TemperatureConn/rawTemperature3: U6.3 (+); also elsewhere on the board
/TemperatureConn/rawTemperature5: U14.3 (+); also elsewhere on the board
/TemperatureFilters/Temperature1: C31.2, R48.2, TP14.1, U13.7; also elsewhere on the board
/TemperatureFilters/Temperature2: C30.2, R47.2, TP13.1, U12.7; also elsewhere on the board
/TemperatureFilters/Temperature3: C27.2, R40.2, TP12.1, U6.7; also elsewhere on the board
/TemperatureFilters/Temperature5: C33.2, R52.2, TP15.1, U14.7; also elsewhere on the board
GNDA: C6.2, C7.2, C8.2, C9.2, U6.4 (V-), U12.4 (V-), U13.4 (V-), U14.4 (V-); also elsewhere on the board
unnamed: C26.2, R39.1
unnamed: C28.2, R45.1
unnamed: C29.2, R46.1
unnamed: C32.2, R51.1
unnamed: R37.2, R38.1
unnamed: R41.2, R43.1
unnamed: R42.2, R44.1
unnamed: R49.2, R50.1
unnamed: R37.1, U6.1, U6.2 (-)
unnamed: C26.1, C27.1, R38.2, U6.5 (+)
unnamed: R39.2, R40.1, U6.6 (-)
unnamed: R41.1, U12.1, U12.2 (-)
unnamed: C28.1, C30.1, R43.2, U12.5 (+)
unnamed: R45.2, R47.1, U12.6 (-)
unnamed: R42.1, U13.1, U13.2 (-)
unnamed: C29.1, C31.1, R44.2, U13.5 (+)
unnamed: R46.2, R48.1, U13.6 (-)
unnamed: R49.1, U14.1, U14.2 (-)
unnamed: C32.1, C33.1, R50.2, U14.5 (+)
unnamed: R51.2, R52.1, U14.6 (-)
VDDA: C6.1, C7.1, C8.1, C9.1, U6.8 (V+), U12.8 (V+), U13.8 (V+), U14.8 (V+); also elsewhere on the board

Notes on the sheet:
tempOut at 85C
tempOut at 10C
tempIn is formed by a divider between a thermistor and 6.49k resistor
Assuming VDDA = 3.3V: At 10C, Rtherm = 226.2k ohms, tempOut = 184mV At 85C, Rtherm = 6.834k ohms, tempOut = 3.21V Very low temperature less than ~5C are seen as GND Very high temperatures greater than ~90C are seen as close to 3.3V Best solution will be achieved between 10C and 85C

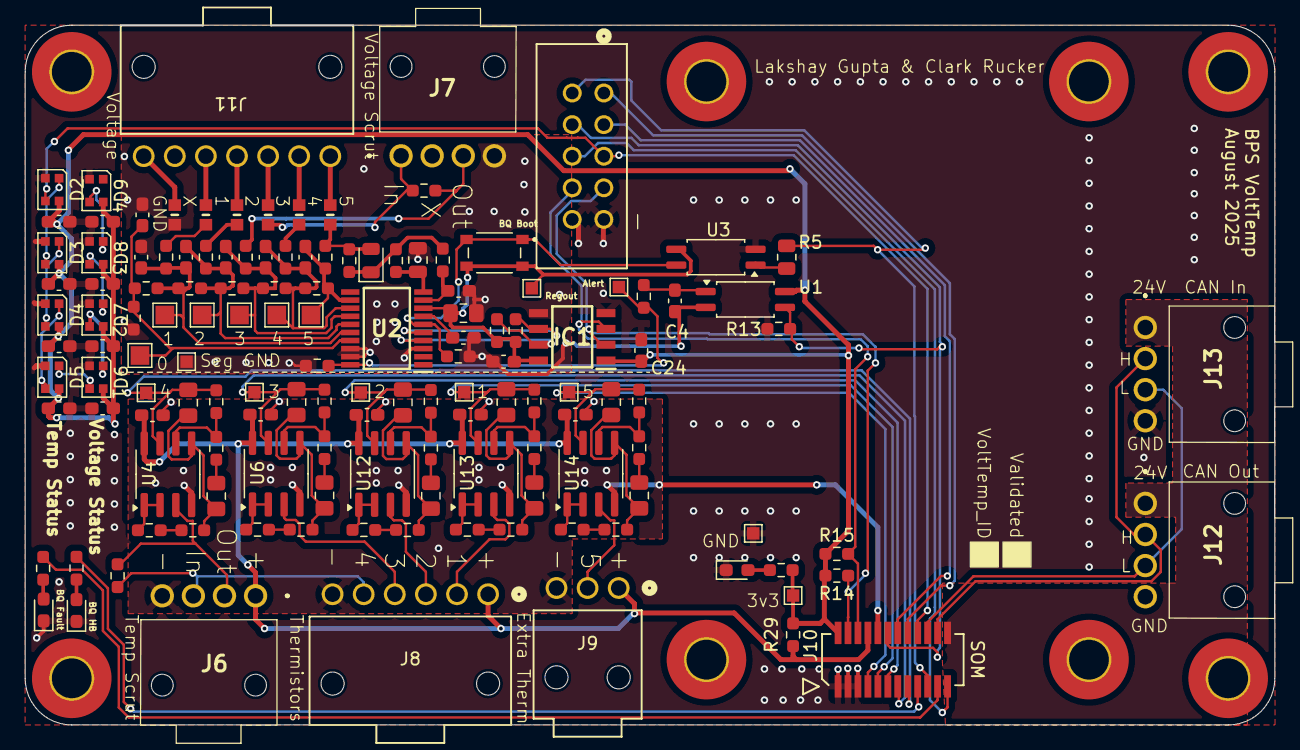
[picture p14: board BPS-Voltage_Temp_Board.kicad_pcb from above]

Board: 2 copper layers, 100.4 x 56.2 mm, 144 parts (1 on the bottom side), 93 nets.
