lhr-solar/BPS-VoltTemp/VoltTemp.ioc

Mcu.UserName=STM32L431CBTx
PA0.Signal=ADCx_IN5
PA10.Signal=USART1_RX
PA11.Signal=GPIO_Output
PA12.Signal=GPIO_Output
PA2.Signal=ADCx_IN7
PA4.Signal=ADCx_IN9
PA5.Signal=ADCx_IN10
PA6.Signal=ADCx_IN11
PA7.Signal=GPIO_Output
PA8.Signal=GPIO_Output
PA9.Signal=USART1_TX
PB0.Signal=GPIO_Output
PB1.Signal=ADCx_IN16
PB10.Signal=S_TIM2_CH3
PB11.Signal=GPIO_Output
PB12.Signal=GPXTI12
PB6.Signal=I2C1_SCL
PB7.Signal=I2C1_SDA
PB8.Signal=CAN1_RX
PB9.Signal=CAN1_TX
