lhr-solar/BPS-VoltTemp/firmware/driver/Src/common.c

#include "common.h"
#include "stm32xx_hal.h"

void gpio_clock_enable(uint32_t port){
    switch (port) {
        case (uint32_t)GPIOA:
            __HAL_RCC_GPIOA_CLK_ENABLE();
            break;
        case (uint32_t)GPIOB:
            __HAL_RCC_GPIOB_CLK_ENABLE();
            break;
        case (uint32_t)GPIOC:
            __HAL_RCC_GPIOC_CLK_ENABLE();
            break;
        case (uint32_t)GPIOD:
            __HAL_RCC_GPIOD_CLK_ENABLE();
            break;
        case (uint32_t)GPIOE:
            __HAL_RCC_GPIOE_CLK_ENABLE();
            break;
    }
}
