lhr-solar/BPS-VoltTemp/(commit log)

2025-08-20 schematic mostly done
    [BPS-Voltage_Temp_Board.kicad_pcb, BPS-Voltage_Temp_Board.kicad_sch, FaultIndicators.kicad_sch, TemperatureConn.kicad_sch, TemperatureFilter.kicad_sch, TemperatureFilters.kicad_sch, VoltageConn.kicad_sch, VoltageSense.kicad_sch]
2025-08-21 layout2 electric boogaloo
    [BPS-Voltage_Temp_Board.kicad_pcb, BPS-Voltage_Temp_Board.kicad_sch, FaultIndicators.kicad_sch, TemperatureConn.kicad_sch, TemperatureFilters.kicad_sch]
2025-08-21 most layout done
    [BPS-Voltage_Temp_Board.kicad_pcb, BPS-Voltage_Temp_Board.kicad_sch, TemperatureFilter.kicad_sch, VoltageConn.kicad_sch, VoltageSense.kicad_sch]
2025-08-21 some ocd stuff
    [BPS-Voltage_Temp_Board.kicad_pcb, BPS-Voltage_Temp_Board.kicad_sch]
2025-08-22 add thermistor test board, just need to route volttemp testpoints
    [BPS-Voltage_Temp_Board.kicad_pcb, BPS-Voltage_Temp_Board.kicad_sch, FaultIndicators.kicad_sch, TemperatureConn.kicad_sch, TemperatureFilter.kicad_sch, TemperatureFilters.kicad_sch, ThermistorBreakoutPCB.kicad_pcb, ThermistorBreakoutPCB.kicad_sch]
2025-08-22 redid thermistor board
    [BPS-Voltage_Temp_Board.kicad_pcb, ThermistorBreakoutPCB.kicad_pcb, ThermistorBreakoutPCB.kicad_sch, thermistorDivider.kicad_sch]
2025-08-22 forgot silkscreen
    [ThermistorBreakoutPCB.kicad_pcb]
2025-08-23 add cell simulator
    [CellSimulatorPCB.kicad_pcb, CellSimulatorPCB.kicad_sch]
2025-08-23 voltage testpoints
    [BPS-Voltage_Temp_Board.kicad_pcb, BPS-Voltage_Temp_Board.kicad_sch, FaultIndicators.kicad_sch, TemperatureFilter.kicad_sch, VoltageSense.kicad_sch]
2025-08-23 done except for nanofit footprints
    [BPS-Voltage_Temp_Board.kicad_pcb, BPS-Voltage_Temp_Board.kicad_sch, TemperatureFilter.kicad_sch, VoltageSense.kicad_sch]
2025-08-23 move one trace
    [BPS-Voltage_Temp_Board.kicad_pcb]
2025-08-23 change 4.7pF cap to 470pF
    [BPS-Voltage_Temp_Board.kicad_pcb, BPS-Voltage_Temp_Board.kicad_sch, TemperatureFilter.kicad_sch, VoltageSense.kicad_sch]
2025-08-23 center things
    [TemperatureFilters.kicad_sch]
2025-08-23 update connector silkscreen
    [BPS-Voltage_Temp_Board.kicad_pcb]
2025-08-23 update cubemx
    [BPS-Voltage_Temp_Board.kicad_pcb, BPS-Voltage_Temp_Board.kicad_sch, TemperatureFilter.kicad_sch, VoltageSense.kicad_sch]
2025-08-23 fixed nanofit footprints and add labels to can in can out connectors
    [BPS-Voltage_Temp_Board.kicad_pcb, BPS-Voltage_Temp_Board.kicad_sch, TemperatureFilter.kicad_sch, VoltageSense.kicad_sch]
2025-08-24 changed bild to sharepoint
    [BPS-Voltage_Temp_Board.kicad_pcb, BPS-Voltage_Temp_Board.kicad_sch, CellSimulatorPCB.kicad_pcb, FaultIndicators.kicad_sch, TemperatureFilter.kicad_sch, TemperatureFilters.kicad_sch, VoltageSense.kicad_sch]
2025-08-24 only check if volttemp is specified when building code
2025-08-25 ravi shah
    [BPS-Voltage_Temp_Board.kicad_pcb, BPS-Voltage_Temp_Board.kicad_sch, TemperatureFilter.kicad_sch, VoltageConn.kicad_sch, VoltageSense.kicad_sch]
2025-08-26 added some jlcpcb files
    [BPS-Voltage_Temp_Board.kicad_pcb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]
2025-08-26 volttemp gerbers
    [BPS-Voltage_Temp_Board-CuBottom.gbr, BPS-Voltage_Temp_Board-CuTop.gbr, BPS-Voltage_Temp_Board-EdgeCuts.gbr, BPS-Voltage_Temp_Board-MaskBottom.gbr, BPS-Voltage_Temp_Board-MaskTop.gbr, BPS-Voltage_Temp_Board-NPTH.drl, BPS-Voltage_Temp_Board-PTH.drl, BPS-Voltage_Temp_Board-SilkBottom.gbr]
2025-09-03 Rev A (#2)
    * new folder structure
    * refactored repo
    * progress
    * added kicad-bild
    * fix footprint references
    * wrote makefile
    * pragma and config + extra fix for if no .vscode
    * add .vscode to gitignore
    * populated some led and gpio functions
    * add compile commands to .gitignore
    * lowercase
    * fixed makefile for running tests
    * more progress on schematic
    * add scrutineering stuff
    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
    [1053131102.stp, 1053131104.stp, 1053131105.stp, B3SL_100[]P.step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]
2025-09-03 Bom (#3)
    * bom
    * bom for cell sim and thermistor
    * stopped displaying part numbers in schematic
    [BPS-Voltage_Temp_Board.kicad_sch, CellSimulatorPCB.kicad_sch, CellSimulatorPCB_BOM.xlsx, FaultIndicators.kicad_sch, TemperatureConn.kicad_sch, TemperatureFilter.kicad_sch, ThermistorBreakoutPCB_BOM.xlsx, VoltTempBOM.xlsx]
2025-09-09 fix diode and last fuse p/n (#4)
    [VoltTempBOM.xlsx]
2025-09-22 Scrutineering (#5)
    * initial schematic and layout
    * updated layout
    * schematic with graphics/mounting
    * graphics stuff
    * fixed routing
    * BOM and gerber (still need to find jack P/N)
    * final
    * revert back to main...
    * added Scrutineering footprints
    * added Scrutineering 3d models
    * BOM and gerber with changed connector
    [Scrutineering-CuBottom.gbr, Scrutineering-CuTop.gbr, Scrutineering-EdgeCuts.gbr, Scrutineering-MaskBottom.gbr, Scrutineering-MaskTop.gbr, Scrutineering-NPTH.drl, Scrutineering-PTH.drl, Scrutineering-SilkBottom.gbr]
